MarcoPicoW/RotFieldLiTE/(commit log)

2026-07-08 Add initial implementation of festival phone bell ringer with LED indicator
2026-07-15 Fix display init and dial debounce in festival phone sketch
    Switch from unavailable Arduino_GFX_Library to Adafruit GFX + ST7789
    driver (only Adafruit libs were installed), and replace the ISR-based
    pulse debounce with a stable-level polling debounce to reliably count
    dial pulses despite mechanical contact bounce. Adds optional serial
    debug logging for pulse timing diagnostics.
    [festival_phone_dial_display.ino]
2026-09-30 Add incoming calls, answer on lift and bell ringing
    - Pi dialer: background thread reads SIM7600 URCs (RING, +CLIP, NO CARRIER,
    VOICE CALL: END, MISSED_CALL) and sends INCOMING [number] / CALLEND to the
    RP2350; ANSWER from the RP2350 -> ATA. INCOMING is repeated on every RING
    as a keepalive for the bell. Line-buffered stdout for journalctl.
    - RP2350 sketch: shows the caller on the display (backlight on even with the
    handset down), sends ANSWER when the handset is lifted while ringing, and
    drives the bell through the L298N on GP0/GP1 with a non-blocking version of
    suoneria_rp2040.ino (only while ringing with the handset down, 12 s
    watchdog).
    - README: incoming-call protocol, bel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
    [festival_phone_dial_display.ino, festival_phone_dialer.py, rp2350_zero_neopixel_pin26.ino]
2026-10-04 Document low-power bell driver plan for the portable version
2026-10-06 Replace Waveshare PDF with wiki link, use neutral example number
    [festival_phone_dialer.py]
